breizhcamp/LikeBox/README.md

LikeBox
=======

See [http://www.likebox.io]

Installation node.js sur Raspberry Pi :
```
sudo wget http://node-arm.herokuapp.com/node_latest_armhf.deb
sudo dpkg -i node_latest_armhf.deb
```

Vérification :
```
node -v
npm -v
```
