breizhcamp/LikeBox/hardware/Facade.pdf

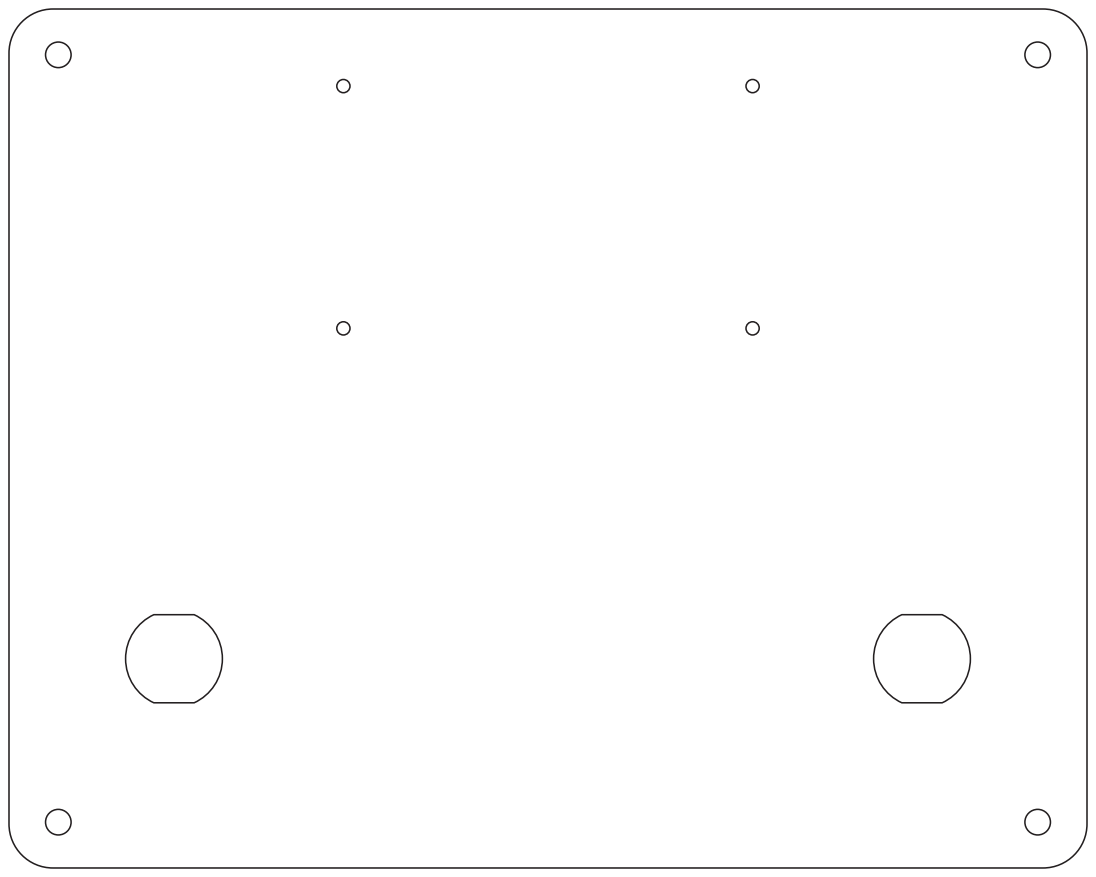
[picture p2: page 1]
debug; RTC; Audio 26 25 2 1
