breizhcamp/LikeBox/hardware/Socle.pdf

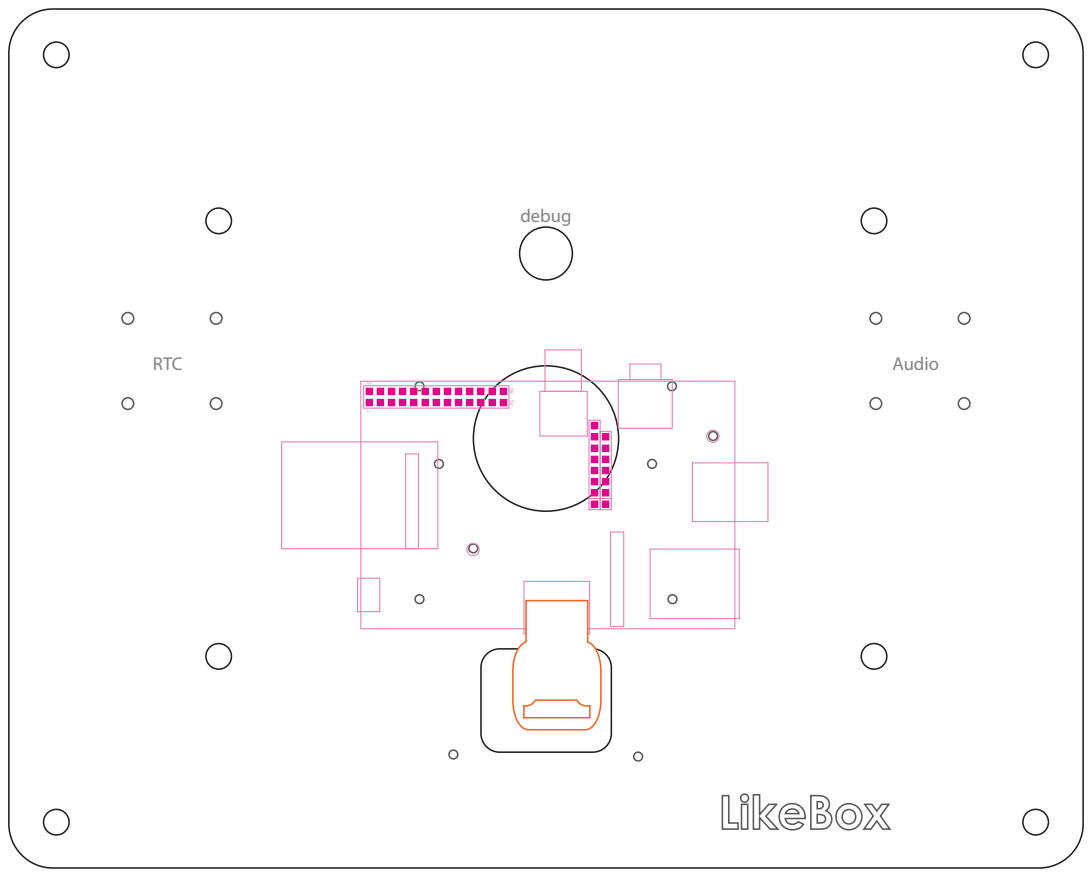
[picture p3: page 1]
debug; RTC; Audio 26 25 2 1
