breizhcamp/LikeBox/(list of files, drawings)

Other design files:
client/docs/wiring.fzz
