breizhcamp/LikeBox/client/docs/wiring_2014_04_27.png

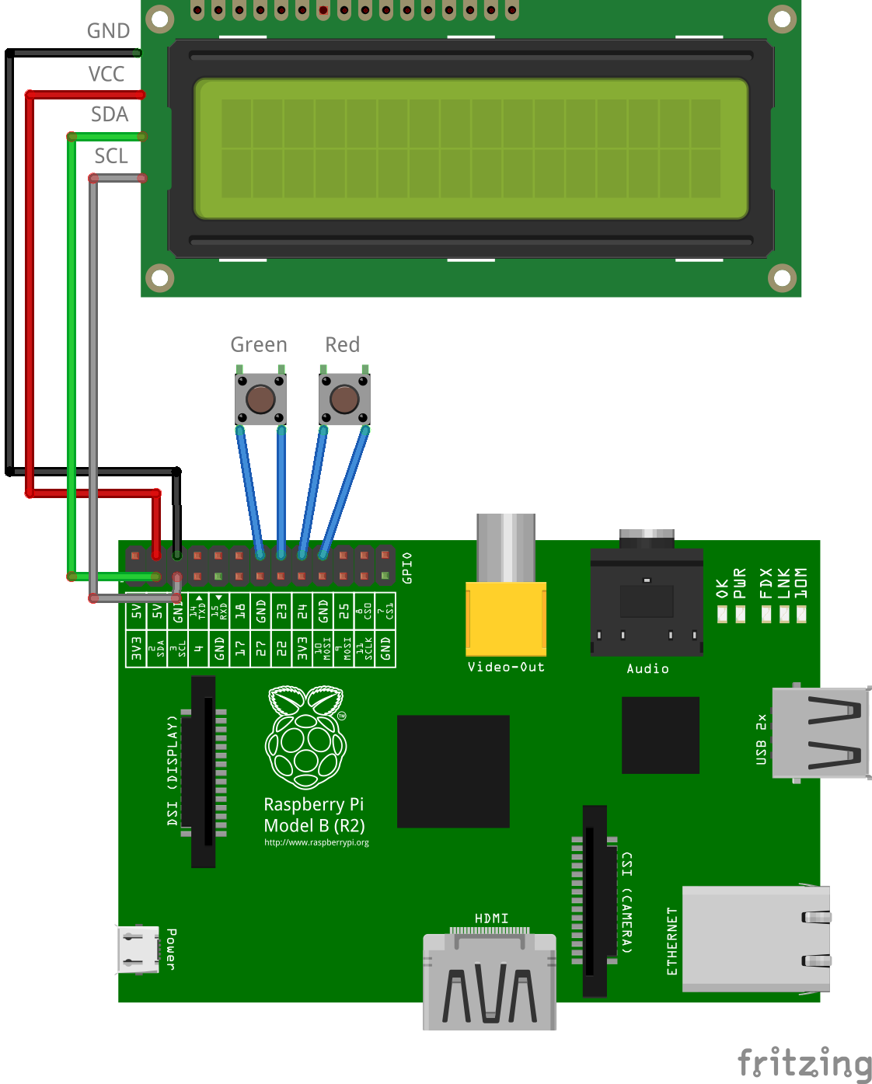
client/docs/wiring_2014_04_27.png
