breizhcamp/LikeBox/(commit log)

2014-04-06 ajout du curseur des votes
2014-04-07 Un peu de cosmétique... et du texte qui bouge ! :-D
2014-04-07 parsing du json, récupération de la session en cours, calcul des dates de début et de fin
2014-04-07 Mise à jour des dépendance de module : ajout de JSONPath
2014-04-07 début de l'implémentation du paramétrage
2014-04-07 ajout du json de l'année dernière
2014-04-08 connexion des web services de paramétrage
2014-04-08 Passage à un Select pour le choix de la date
2014-04-08 Correction d'un bug sur le choix de la salle
2014-04-08 câblage du vote avec le numéro de session
2014-04-08 Masquage du div contenant l'id de session
2014-04-08 Correction du nom de la salle Belle-Île-en-Mer
2014-04-09 Correction bug sur la barre de vote, remise à zéro du défilement si changement de salle ou d'heure
2014-04-09 uniformisation des noms de variables et de fontions
2014-04-09 un peu de cosmétique :)
2014-04-27 Adding wiring schematics
    [wiring.fzz]
2014-04-27 Adding button module
2014-04-29 Début de l'implémentation serveur
2014-05-11 ajout du service status, passage en minuscule des noms de services
2014-05-11 ajout du service top permettant de renvoyer les sessions ayant les meilleurs votes
2014-05-11 ajout sur / d'une page affichant les 5 meilleures confs
2014-05-12 affichage du titre de la conf à la place du sessionId
2014-05-12 passage de la page d'affichage des votes à une liste ordonnée pour faire plaisir à ndeloof :P
2014-05-13 Displaying current session and time left
2014-05-13 Displaying vote count and set behaviour when button pressed
2014-05-15 Utilisation des id de boitier comme paramètre à la place des id de session pour les services /vote et /status
2014-05-16 correction de l'indentation pour faire plaisir à lhuet :D
2014-05-18 ajout des dépendances npm
2014-05-18 ajout de l'authentification
2014-05-19 Vérification de la présence du talk dans le schedule
2014-05-19 Amélioration de la vérification de présence du talk dans le schedule
2014-05-19 Modify debounce to avoid keyup if button already up (same for keydown)
2015-09-23 inverting buttons
2015-09-23 changed button wiring and added RTC clock
    [wiring.fzz]
2015-09-23 updated schematics
